xtitoris/hellen-efi/misc/Refs/case.jpg

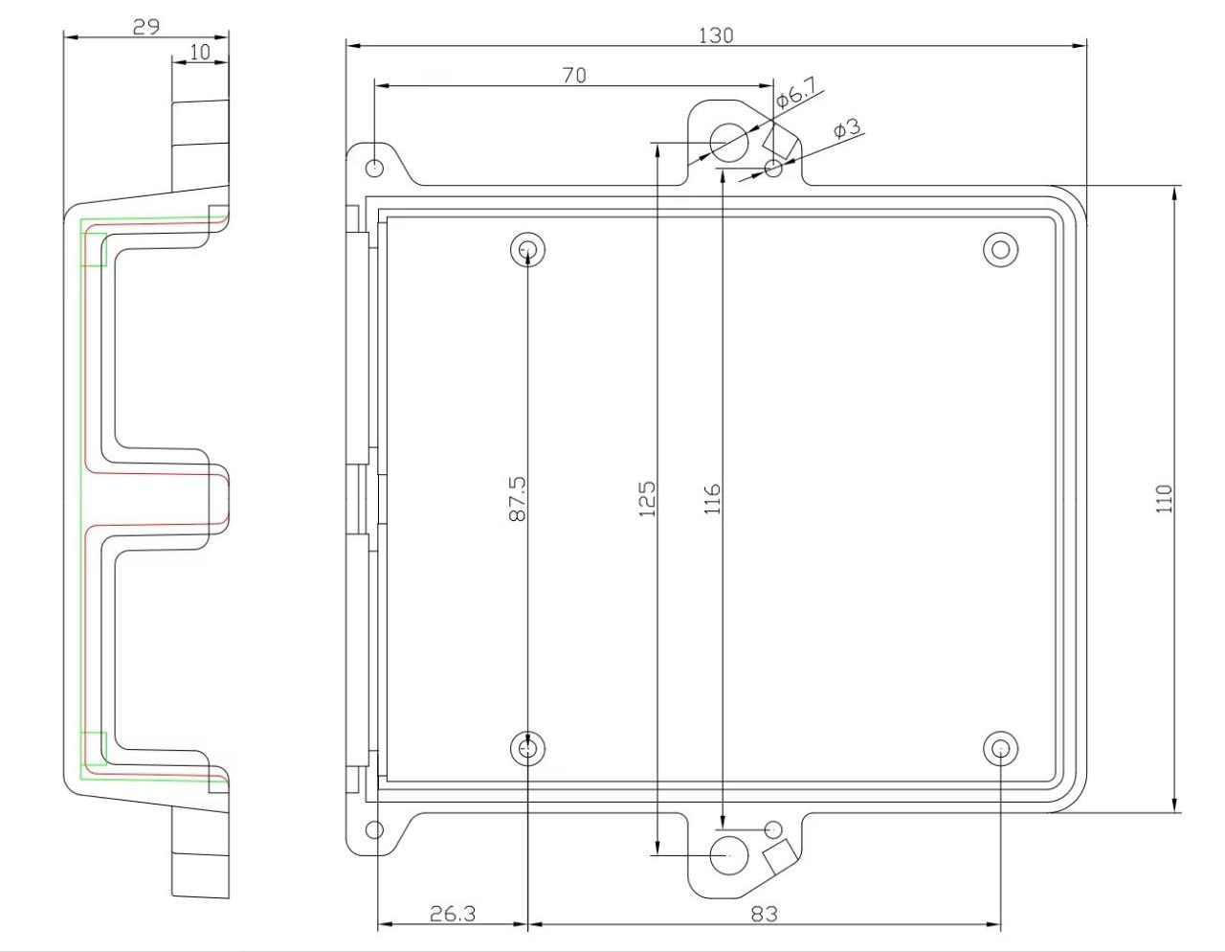
misc/Refs/case.jpg
