xtitoris/hellen-efi/misc/Refs/Conn.jpg

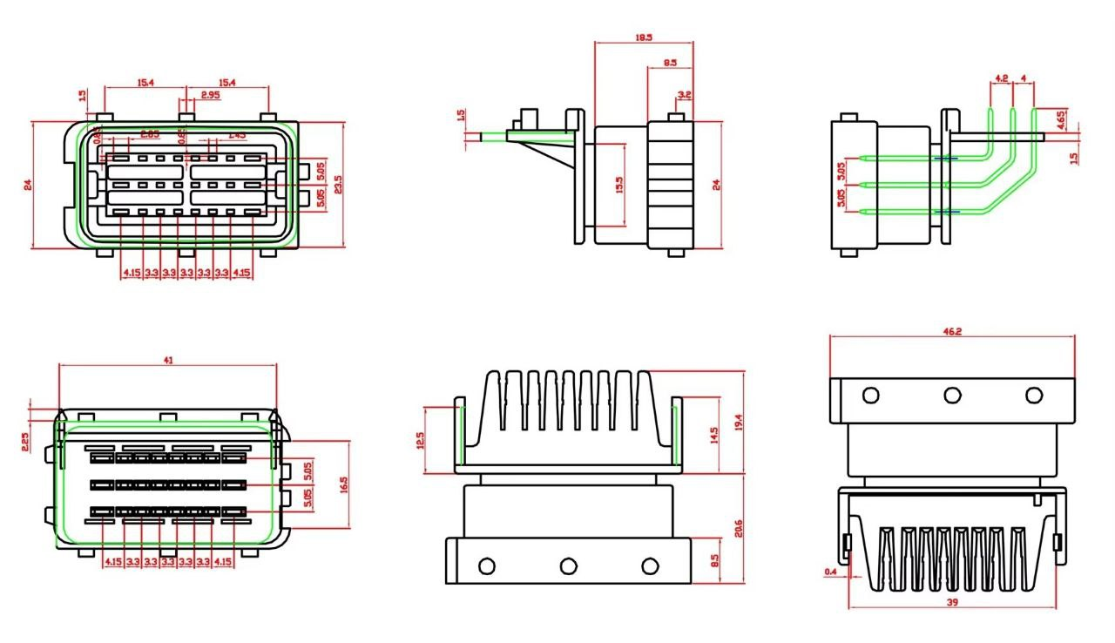
misc/Refs/Conn.jpg
