xtitoris/hellen-efi/misc/JDY-33.STEP

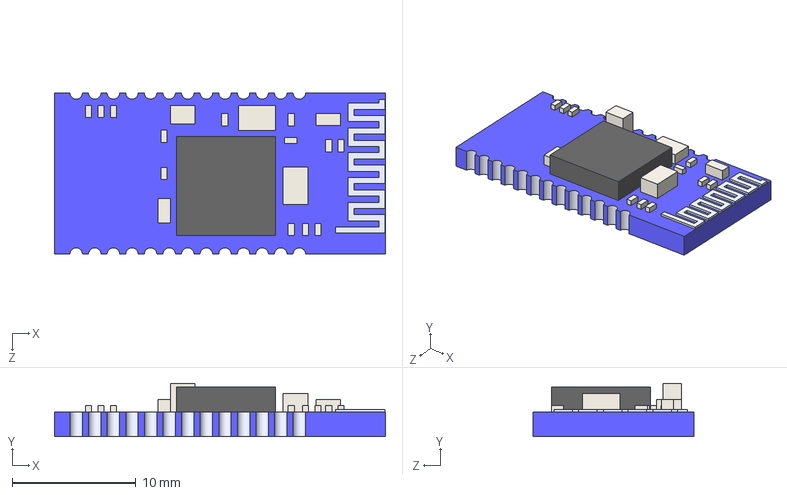
[picture p3: CAD file, 2026-09-19]
misc/JDY-33.STEP
26.7 x 4.30 x 13.0 mm
