xtitoris/hellen-efi/misc/Refs/outline.dxf

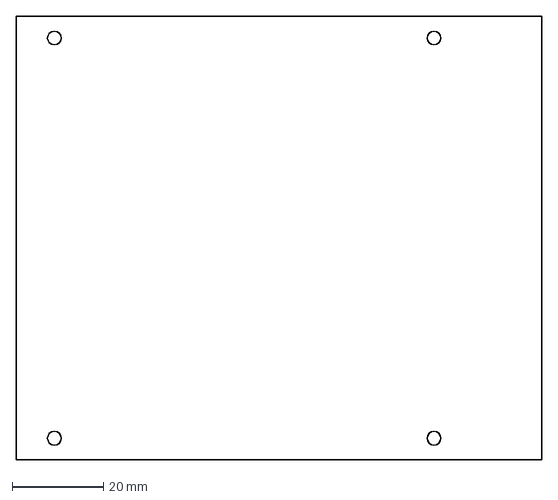
[picture p4: CAD file, 2025-12-07]
misc/Refs/outline.dxf
115.0 x 97.0 mm
