xtitoris/hellen-efi/misc/Refs/pcb.dxf

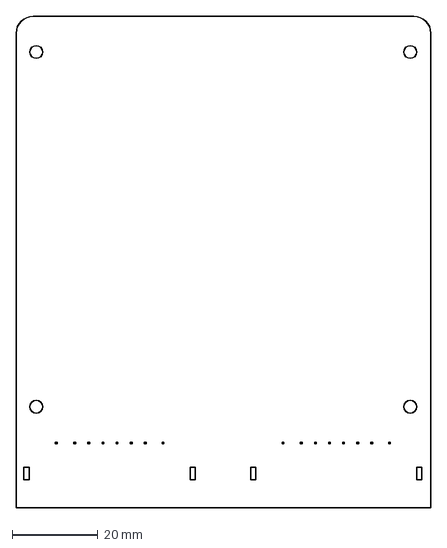
[picture p5: CAD file, 2025-12-07]
misc/Refs/pcb.dxf
97.0 x 115.0 mm
