xtitoris/hellen-efi/trove8.kicad_pcb

## KiCad design trove8.kicad_pcb (2026-09-19)

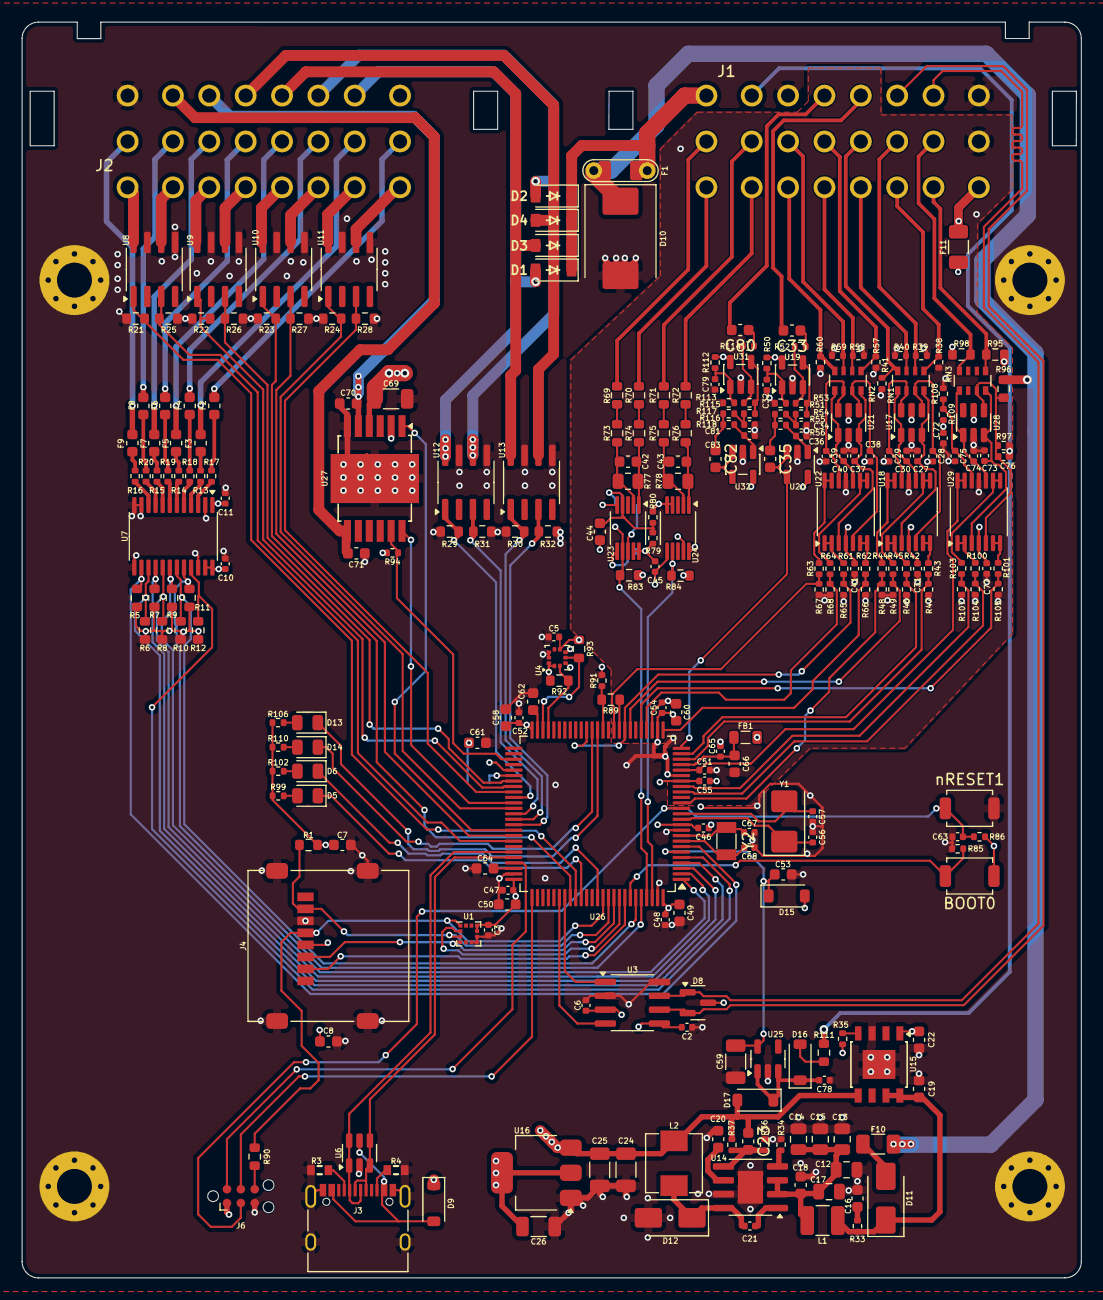
[picture p6: board trove8.kicad_pcb from above]

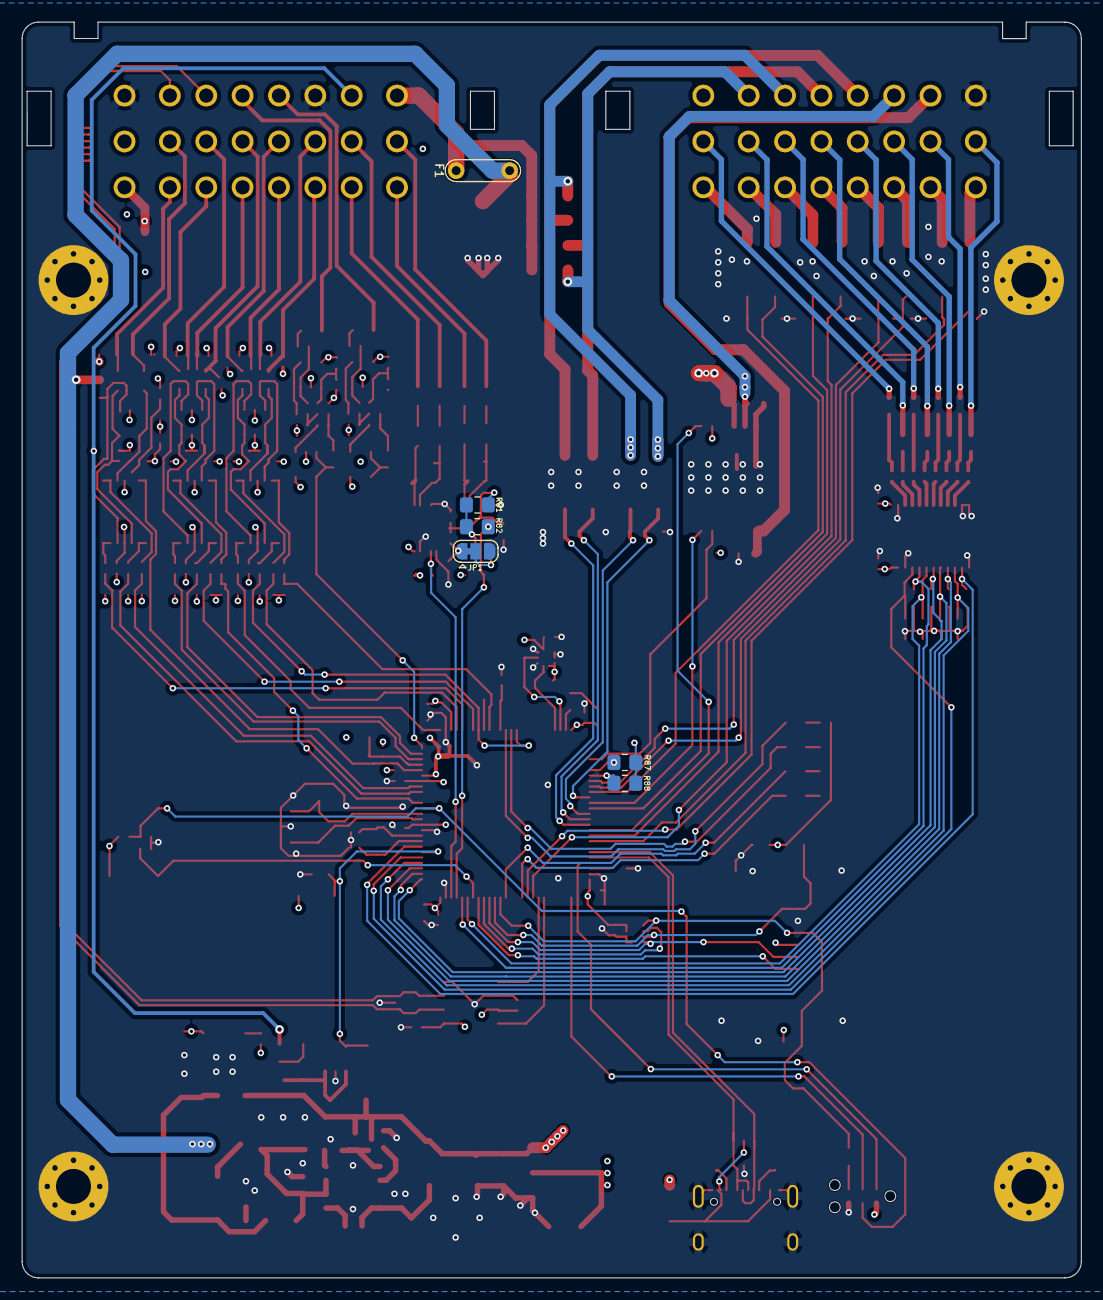
[picture p7: board trove8.kicad_pcb from below]

Board: 4 copper layers, 97.0 x 115.0 mm, 274 parts (5 on the bottom side), 204 nets.

Parts:
BOOT0: SW_Push; SW_SPST_TS-1088-xR020
C2, C3, C5, C6, C10, C11, C21, C27, C28, C29, C30, C31, C37, C38, C39, C40, C41, C45, C46, C47, C48, C51, C52, C54, C55, C63, C65, C72, C73, C74, C75, C77, C78: 100n; C_0402_1005Metric
C7, C8: 22u; C_0603_1608Metric
C12, C13, C14, C15, C17: 10u; C_0805_2012Metric
C16, C49, C50, C53, C58, C60, C66: 4.7u; C_0603_1608Metric
C18, C19, C22, C44, C61: 1u; C_0603_1608Metric
C20, C70, C71: 10n; C_0603_1608Metric
C23, C35, C82: 330p; C_0603_1608Metric
C24, C69: 10u; C_1206_3216Metric
C25, C26, C59: 47u; C_1206_3216Metric
C32, C79: 10n; C_0402_1005Metric
C33, C80: 3.3n; C_0603_1608Metric
C34, C81: 680p; C_0402_1005Metric
C36, C83: 47p; C_0402_1005Metric
C42, C43: 1n; C_0603_1608Metric
C56, C57: 18p; C_0402_1005Metric
C62, C64: 2.2u; C_0603_1608Metric
C67, C68: 15p; C_0402_1005Metric
C76: 1u; C_0402_1005Metric
D1, D2, D3, D4: B5819W; SOD-123
D5: RED; LED_0805_2012Metric
D6: GREEN; LED_0805_2012Metric
D8: PESD1CAN; SOT-23
D9, D15, D16, D17: 1N5819WS; D_SOD-123
D10: SM15T33CA; D_SMC
D11, D12: SS34; D_SMA
D13: BLUE; LED_0805_2012Metric
D14: YELLOW; LED_0805_2012Metric
F1: 12H1500D; PAD-1206-PAD
F2, F3, F4, F5, F6, F7, F8, F9: 50mA; Fuse_0603_1608Metric
F10: Polyfuse; Fuse_1206_3216Metric
F11: 120mA; Fuse_1206_3216Metric
FB1: Ferrite_Bead; L_0805_2012Metric
H1, H2, H3, H4: M3; MountingHole_3.2mm_M3_Pad_Via
J1: CONN_INPUTS; Delphi_Sicma_24_Black
J2: CONN_OUTPUTS; Delphi_Sicma_24_Grey
J3: USB_C
J4: Micro_SD_Card; microSD_HC_Molex_47219-2001
J6: Conn_01x06; Tag-Connect_TC2030-IDC-NL_2x03_P1.27mm_Vertical
JP1: Jumper_3_Bridged12; SolderJumper-3_P1.3mm_Bridged12_RoundedPad1.0x1.5mm
L1: 2.2u; L_1210_3225Metric
L2: 10u; MWSA0503
NT1: NetTie_2; NetTie-2_SMD_Pad0.5mm
R1: 33k; R_0603_1608Metric
R3, R4: 5.6k; R0603
R5, R6, R7, R8, R9, R10, R11, R12, R21, R22, R23, R24, R25, R26, R27, R28, R29, R30, R31, R32, R69, R70, R71, R72, R73, R74, R75, R76, R83, R84: 4.7k; R_0603_1608Metric
R13, R14, R15, R16, R17, R18, R19, R20: 10; R_0402_1005Metric
R33: 1; R_0402_1005Metric
R34, R35, R85, R86, R91, R94, R97: 10k; R_0402_1005Metric
R36, R54, R116: 12k; R_0402_1005Metric
R37: 68k; R_0402_1005Metric
R38, R39, R40, R41, R53, R57, R58, R59, R60, R115: 470k; R_0402_1005Metric
R42, R43, R44, R45, R46, R47, R48, R49, R61, R62, R63, R64, R65, R66, R67, R68, R100, R101, R103, R104, R105, R107, R108, R109: 4k7; R_0402_1005Metric
R50, R51, R56, R112, R113, R118: 33k; R_0402_1005Metric
R52, R55, R114, R117: 100k; R_0402_1005Metric
R77, R78: DNP; R_0805_2012Metric
R79, R80: 1k; R_0402_1005Metric
R81, R82, R87, R88: DNP; R_0805_2012Metric_Pad1.20x1.40mm_HandSolder
R89: 0; R_0603_1608Metric
R90: 100; R_0603_1608Metric
R92, R93: 2k2; R_0603_1608Metric
R95, R98: 2.7k; R_0603_1608Metric
R96: 48.7k; R_0603_1608Metric
R99, R102, R106, R110: 470; R_0402_1005Metric
R111: 6.8k; R_0603_1608Metric
RN1, RN2, RN3: 10k; R_Array_Convex_4x0603
U1: LIS2DW12TR; LGA-12_2x2mm_P0.5mm
U3: TJA1051T-3; SOIC-8_3.9x4.9mm_P1.27mm
U4: LPS22HB; ST_HLGA-10_2x2mm_P0.5mm_LayoutBorder3x2y
U6: USBLC6-2SC6; SOT-23-6
U7: SN74LVC4245APWR; TSSOP-24_4.4x7.8mm_P0.65mm
U8, U9, U10, U11, U12, U13: VNLD5160TR-E; SOIC-8_3.9x4.9mm_P1.27mm
U14: LMR14020; SOIC-8-1EP_3.9x4.9mm_P1.27mm_EP2.29x3mm
U15: TLS115; Infineon_PG-DSO-8-43
U16: AMS1117-3.3; SOT-223-3_TabPin2
U17, U21, U28: SRV05-4; SOT-23-6
U18, U22, U29: MCP6004; TSSOP-14_4.4x5mm_P0.65mm
U19, U20, U31, U32: LMV321; SOT-23-5
U23, U24: MAX9924; MSOP-10_3x3mm_P0.5mm
U25: MIC5205-3.3YM5; SOT-23-5
U26: STM32F427VGTx; LQFP-100_14x14mm_P0.5mm
U27: TLE9201SG; Infineon_PG-DSO-12-9
Y1: 20MHz; Crystal_SMD_5032-2Pin_5.0x3.2mm
Y2: 32.768 kHz; Crystal_SMD_3215-2Pin_3.2x1.5mm
nRESET1: SW_Push; SW_SPST_TS-1088-xR020

Connections:
+3.3V: BOOT0.2, C2.1, C3.1, C5.1, C7.1, C8.1, C10.1, C26.1, C46.2, C47.2, C48.2, C49.2, C50.2, C52.2, C54.2, C55.2, C58.2, C60.2, D15.2 (A), FB1.1, J4.4 (VDD), J6.1, R1.1, R35.2, R50.2, R83.1, R84.1, R86.2, R92.2, R93.2, R94.2, R99.1, R102.1, R106.1, R110.1, R112.2, U1.9 (Vdd), U1.10 (Vdd_IO), U3.5 (VIO), U4.1 (Vdd_IO), U4.6 (~CS), U4.10 (VDD), U7.23 (V_{CCB}), U7.24 (V_{CCB}), U16.2 (VO), U19.5 (V+), U20.5 (V+), U26.11 (VDD), U26.19 (VDD), U26.28 (VDD), U26.50 (VDD), U26.75 (VDD), U26.100 (VDD), U27.2 (VSO), U31.5 (V+), U32.5 (V+)
+5V: C6.1, C11.1, C23.1, C24.1, C25.1, C45.1, D9.1 (K), D17.2 (A), JP1.1 (A), L2.2, R37.2, R79.1, U3.3 (VCC), U7.1 (V_{CCA}), U15.5 (ADJ), U16.3 (VI), U23.9 (INT_THRS), U23.10 (VCC), U24.10 (VCC)
+5VA: C22.1, C31.1, C41.1, C72.2, C77.1, F11.1, R95.1, R98.1, R109.1, U15.1 (OUT), U17.5 (VP), U18.4 (V+), U21.5 (VP), U22.4 (V+), U28.5 (VP), U29.4 (V+)
+12V_IN: C69.2, D1.1 (K), D2.1 (K), D3.1 (K), D4.1 (K), F1.1, J1.C1, U27.4 (VS)
+12V_PERM: J1.C2, R111.1
+12V_PROT: C19.1, D11.1 (K), L1.1, R33.1, U15.7 (EN), U15.8 (IN)
+12V_RAW: D10.1 (A1), F1.2, F10.1, R96.1
/ACC_CS: U1.2 (~CS), U26.92 (PB6)
/Analog 3 Pullup/IN1_PRE: C73.1, RN3.8 (R1.2), U28.3 (IO2), U29.3 (+)
/Analog 3 Pullup/IN2_PRE: C74.1, RN3.5 (R4.2), U28.1 (IO1), U29.10 (+)
/Analog 3 Pullup/VIGN_PRE: C76.1, R96.2, R97.1, RN3.7 (R2.2), U28.4 (IO3), U29.5 (+)
/Analog 3 Pullup/VREF_PRE: C75.1, R108.1, R109.2, U29.12 (+)
/BARO_SCL: R92.1, U4.2 (SCL), U26.47 (PB10)
/BARO_SDA: R93.1, U4.4 (SDA), U26.48 (PB11)
/CAN1_RX: U3.4 (RXD), U26.81 (PD0)
/CAN1_TX: U3.1 (TXD), U26.82 (PD1)
/CAN_N: D8.2 (D), J1.C6, U3.6 (CANL)
/CAN_P: D8.1 (G), J1.C7, U3.7 (CANH)
/DC1_DIS: R94.1, U26.53 (PB14), U27.11 (DIS)
/IGN_1: F9.1, J2.B1
/IGN_2: F8.1, J2.B2
/IGN_3: F7.1, J2.B3
/IGN_4: F6.1, J2.B4
/IGN_5: F5.1, J2.B5
/IGN_6: F4.1, J2.B6
/IGN_7: F3.1, J2.B7
/IGN_8: F2.1, J2.B8
/INJ_1: J2.A1, U8.8 (D1)
/INJ_2: J2.A2, U8.6 (D2)
/INJ_3: J2.A3, U9.8 (D1)
/INJ_4: J2.A4, U9.6 (D2)
/INJ_5: J2.A5, U10.8 (D1)
/INJ_6: J2.A6, U10.6 (D2)
/INJ_7: J2.A7, U11.8 (D1)
/INJ_8: J2.A8, U11.6 (D2)
/IN_AC_CLUTCH: J1.B5, R41.1, RN1.4 (R4.1)
/IN_CAM_NEGATIVE: J1.A2, R72.2
/IN_CAM_PRIMARY: J1.B2, R71.2
/IN_CLT: J1.A7, R95.2, RN3.1 (R1.1)
/IN_CRANK_NEGATIVE: J1.A1, R70.2
/IN_CRANK_PRIMARY: J1.B1, R69.2
/IN_IAT: J1.B7, R98.2, RN3.4 (R4.1)
/IN_KNOCK: C33.2, J1.C5
/IN_KNOCK2: C80.2, J1.C4
/IN_MAP: J1.A5, R40.1, RN1.3 (R3.1)
/IN_O2S: J1.A6, R38.1, RN1.1 (R1.1)
/IN_O2S2: J1.B6, R39.1, RN1.2 (R2.1)
/IN_PPS1: J1.A4, R58.1, RN2.2 (R2.1)
/IN_PPS2: J1.B4, R57.1, RN2.1 (R1.1)
/IN_TPS_1: J1.A3, R60.1, RN2.4 (R4.1)
/IN_TPS_2: J1.B3, R59.1, RN2.3 (R3.1)
/Knock1/FILTERED_1: C82.2, U32.3 (-), U32.4
/Knock1/V_mid: C79.2, R112.1, R113.1, U31.1 (+)
/Knock/V_mid: C32.2, R50.1, R51.1, U19.1 (+)
/MCU/BOOT0: BOOT0.1, R85.1, U26.94 (BOOT0)
/MCU/BOOT1: R89.2, R91.1, U26.37 (PB2)
/MCU/LED1: D5.1 (K), U26.85 (PD4)
/MCU/LED2: D6.1 (K), U26.88 (PD7)
/MCU/LED3: D13.1 (K), U26.38 (PE7)
/MCU/LED4: D14.1 (K), U26.39 (PE8)
/MCU/SWCLK: J6.4, U26.76 (PA14)
/MCU/SWDIO: J6.2, U26.72 (PA13)
/MCU/SWO: J6.6, R90.2
/MCU/VDDA: C65.1, C66.1, FB1.2, U26.22 (VDDA)
/MCU/nRESET: C63.2, J6.3, R86.1, U26.14 (NRST), nRESET1.1
/MCU_IGN1: R5.2, U7.14 (B8), U26.7 (PC13)
/MCU_IGN2: R6.2, U7.15 (B7), U26.4 (PE5)
/MCU_IGN3: R7.2, U7.16 (B6), U26.3 (PE4)
/MCU_IGN4: R8.2, U7.17 (B5), U26.2 (PE3)
/MCU_IGN5: R9.2, U7.18 (B4), U26.1 (PE2)
/MCU_IGN6: R10.2, U7.19 (B3), U26.95 (PB8)
/MCU_IGN7: R11.2, U7.20 (B2), U26.96 (PB9)
/MCU_IGN8: R12.2, U7.21 (B1), U26.5 (PE6)
/MCU_INJ1: R21.2, U8.1 (IN1), U26.84 (PD3)
/MCU_INJ2: R25.2, U8.3 (IN2), U26.68 (PA9)
/MCU_INJ3: R22.2, U9.1 (IN1), U26.58 (PD11)
/MCU_INJ4: R26.2, U9.3 (IN2), U26.57 (PD10)
/MCU_INJ5: R23.2, U10.1 (IN1), U26.83 (PD2)
/MCU_INJ6: R27.2, U10.3 (IN2), U26.67 (PA8)
/MCU_INJ7: R24.2, U11.1 (IN1), U26.62 (PD15)
/MCU_INJ8: R28.2, U11.3 (IN2), U26.59 (PD12)
/MCU_IN_AC_CLUTCH: R45.1, R49.2, U26.32 (PA7)
/MCU_IN_AUX_PU1: R89.1, U26.34 (PC5)
/MCU_IN_CAM: R84.2, U24.7 (COUT), U26.98 (PE1)
/MCU_IN_CLT: R100.1, R104.2, U26.17 (PC2)
/MCU_IN_CRANK: R82.1, R83.2, U23.7 (COUT), U26.97 (PE0)
/MCU_IN_IAT: R103.1, R107.2, U26.18 (PC3)
/MCU_IN_KNOCK: C35.2, U20.3 (-), U20.4, U26.25 (PA2)
/MCU_IN_MAP: R44.1, R48.2, U26.15 (PC0)
/MCU_IN_O2S: R42.1, R46.2, U26.24 (PA1)
/MCU_IN_O2S2: R43.1, R47.2, U26.23 (PA0)
/MCU_IN_PPS1: R62.1, R66.2, U26.26 (PA3)
/MCU_IN_PPS2: R61.1, R65.2, U26.33 (PC4), U26.40 (PE9)
/MCU_IN_TPS_1: R64.1, R68.2, U26.29 (PA4)
/MCU_IN_TPS_2: R63.1, R67.2, U26.35 (PB0)
/MCU_IN_VIGN: R101.1, R105.2, U26.30 (PA5)
/MCU_PWM1: R29.2, U12.1 (IN1), U26.60 (PD13)
/MCU_PWM2: R31.2, U12.3 (IN2), U26.63 (PC6)
/MCU_PWM3: R30.2, U13.1 (IN1), U26.64 (PC7)
/MCU_PWM4: R32.2, U13.3 (IN2), U26.65 (PC8)
/MCU_PWM5: U26.66 (PC9), U27.1 (DIR)
/MCU_PWM6: U26.61 (PD14), U27.12 (PWM)
/MCU_VREF: C51.1, U26.21 (VREF+), U29.13 (-), U29.14
/OUT_DH: C70.2, J2.C3, U27.5 (OUT1)
/OUT_DL: C71.1, J2.C2, U27.7 (OUT2)
/OUT_LS1: D1.2 (A), J2.C7, U12.8 (D1)
/OUT_LS2: D2.2 (A), J2.C6, U12.6 (D2)
/OUT_LS3: D3.2 (A), J2.C5, U13.8 (D1)
/OUT_LS4: D4.2 (A), J2.C4, U13.6 (D2)
/SD_CS: J4.2 (DAT3/CD), U26.93 (PB7)
/SPI1_MISO: J4.7 (DAT0), R1.2, U1.3 (SA0/SDO), U26.90 (PB4)
/SPI1_MOSI: J4.3 (CMD), U1.4 (SDA/SDI), U26.91 (PB5)
/SPI1_SCK: J4.5 (CLK), R90.1, U1.1 (SCL/SPC), U26.89 (PB3)
/USB_D+: J3.A6 (D+), J3.B6 (D+), U6.3 (I/O2), U6.4 (I/O2), U26.71 (PA12)
/USB_D-: J3.A7 (D-), J3.B7 (D-), U6.1 (I/O1), U6.6 (I/O1), U26.70 (PA11)
/USB_VBUS: D9.2 (A), J3.A4 (VBUS), J3.A9 (VBUS), J3.B4 (VBUS), J3.B9 (VBUS), U6.5 (VBUS)
/VBAT: C53.1, C59.1, D15.1 (K), U25.5 (OUT), U26.6 (VBAT)
/VReg/5V_SENSOR_1_PG: R35.1, U15.4 (PG)
/VReg/12V_PRE: C12.1, C13.1, C14.1, C15.1, C17.1, C18.1, L1.2, U14.2 (VIN), U14.3 (EN)
GND: C2.2, C3.2, C5.2, C6.2, C7.2, C8.2, C10.2, C11.2, C12.2, C13.2, C14.2, C15.2, C16.2, C17.2, C18.2, C19.2, C20.2, C22.2, C24.2, C25.2, C26.2, C44.2, C45.2, C46.1, C47.1, C48.1, C49.1, C50.1, C52.1, C53.2, C54.1, C55.1, C56.2, C57.2, C58.1, C59.2, C60.1, C61.2, C62.2, C63.1, C64.2, C67.2, C68.2, C69.1, C70.1, C71.2, C78.2, D8.3 (S), D10.2 (A2), D12.2 (A), H1.1 (1_1), H2.1 (1_1), H3.1 (1_1), H4.1 (1_1), J1.C3, J1.C8, J2.C1, J2.C8, J3.A1 (GND), J3.A12 (GND), J3.B1 (GND), J3.B12 (GND), J3.S1 (SHIELD), J4.6 (VSS), J4.9 (SHIELD), J6.5, JP1.3 (B), NT1.1, R3.1, R4.1, R5.1, R6.1, R7.1, R8.1, R9.1, R10.1, R11.1, R12.1, R21.1, R22.1, R23.1, R24.1, R25.1, R26.1, R27.1, R28.1, R29.1, R30.1, R31.1, R32.1, R34.2, R36.2, R80.1, R85.2, R91.2, U1.6 (GND), U1.7 (RES), U1.8 (GND), U3.2 (GND), U3.8 (S), U4.3 (GND), U4.5 (SA0), U4.8 (GND), U4.9 (GND), U6.2 (GND), U7.2 (DIR), U7.11 (GND), U7.12 (GND), U7.13 (GND), U7.22 (~OE), U8.5 (S2), U8.7 (S1), U9.5 (S2), U9.7 (S1), U10.5 (S2), U10.7 (S1), U11.5 (S2), U11.7 (S1), U12.5 (S2), U12.7 (S1), U13.5 (S2), U13.7 (S1), U14.7 (GND), U14.9 (GND), U15.3 (GND), U15.9 (GND), U16.1 (GND), U23.5 (GND), U24.4 (BIAS), U24.5 (GND), U24.6 (ZERO_EN), U24.9 (INT_THRS), U25.2 (GND), U26.10 (VSS), U26.27 (VSS), U26.74 (VSS), U26.99 (VSS), U27.6 (GND), U27.13 (GND), nRESET1.2
GNDA: C27.2, C28.2, C29.2, C30.2, C31.2, C32.1, C34.1, C36.1, C37.2, C38.2, C39.2, C40.2, C41.2, C51.2, C65.2, C66.2, C72.1, C73.2, C74.2, C75.2, C76.2, C77.2, C79.1, C81.1, C83.1, J1.B8, NT1.2, R38.2, R39.2, R40.2, R41.2, R46.1, R47.1, R48.1, R49.1, R51.2, R57.2, R58.2, R59.2, R60.2, R65.1, R66.1, R67.1, R68.1, R97.2, R104.1, R105.1, R107.1, R108.2, R113.2, U17.2 (VN), U18.11 (V-), U19.2 (V-), U20.2 (V-), U21.2 (VN), U22.11 (V-), U26.20 (VSSA), U28.2 (VN), U29.11 (V-), U31.2 (V-), U32.2 (V-)
unnamed: C16.1, R33.2
unnamed: C33.1, R52.2
unnamed: C34.2, R54.1, R55.2
unnamed: C35.1, R55.1, R56.2
unnamed: C61.1, R87.1, R88.1
unnamed: C80.1, R114.2
unnamed: C81.2, R116.1, R117.2
unnamed: C82.1, R117.1, R118.2
unnamed: D5.2 (A), R99.2
unnamed: D6.2 (A), R102.2
unnamed: D11.2 (A), F10.2
unnamed: C21.2, D12.1 (K), L2.1, U14.8 (SW)
unnamed: D13.2 (A), R106.2
unnamed: D14.2 (A), R110.2
unnamed: D16.2 (A), R111.2
unnamed: C78.1, D16.1 (K), D17.1 (K), U25.1 (IN), U25.3 (EN)
unnamed: F2.2, R17.2
unnamed: F3.2, R13.2
unnamed: F4.2, R18.2
unnamed: F5.2, R14.2
unnamed: F6.2, R19.2
unnamed: F7.2, R15.2
unnamed: F8.2, R20.2
unnamed: F9.2, R16.2
unnamed: F11.2, J1.A8
unnamed: J3.A5 (CC1), R3.2
unnamed: J3.B5 (CC2), R4.2
unnamed: JP1.2 (C), U23.6 (ZERO_EN)
unnamed: R53.1, R54.2, U19.4
unnamed: R69.1, R73.2
unnamed: R70.1, R74.2
unnamed: R71.1, R75.2
unnamed: R72.1, R76.2
unnamed: R115.1, R116.2, U31.4
unnamed: C27.1, RN1.8 (R1.2), U17.3 (IO2), U18.3 (+)
unnamed: C28.1, RN1.7 (R2.2), U17.4 (IO3), U18.5 (+)
unnamed: C29.1, RN1.6 (R3.2), U17.6 (IO4), U18.12 (+)
unnamed: C30.1, RN1.5 (R4.2), U17.1 (IO1), U18.10 (+)
unnamed: C37.1, RN2.8 (R1.2), U21.3 (IO2), U22.3 (+)
unnamed: C38.1, RN2.7 (R2.2), U21.4 (IO3), U22.5 (+)
unnamed: C39.1, RN2.6 (R3.2), U21.6 (IO4), U22.12 (+)
unnamed: C40.1, RN2.5 (R4.2), U21.1 (IO1), U22.10 (+)
unnamed: R17.1, U7.3 (A1)
unnamed: R13.1, U7.4 (A2)
unnamed: R18.1, U7.5 (A3)
unnamed: R14.1, U7.6 (A4)
unnamed: R19.1, U7.7 (A5)
unnamed: R15.1, U7.8 (A6)
unnamed: R20.1, U7.9 (A7)
unnamed: R16.1, U7.10 (A8)
unnamed: C21.1, U14.1 (BOOT)
unnamed: C23.2, R36.1, R37.1, U14.5 (FB)
unnamed: R34.1, U14.4 (RT)
unnamed: C20.1, U14.6 (SS)
unnamed: R42.2, U18.1, U18.2 (-)
unnamed: R43.2, U18.6 (-), U18.7
unnamed: R45.2, U18.8, U18.9 (-)
unnamed: R44.2, U18.13 (-), U18.14
unnamed: R52.1, R53.2, U19.3 (-)
unnamed: C36.2, R56.1, U20.1 (+)
unnamed: R61.2, U22.1, U22.2 (-)
unnamed: R62.2, U22.6 (-), U22.7
unnamed: R64.2, U22.8, U22.9 (-)
unnamed: R63.2, U22.13 (-), U22.14
unnamed: C44.1, R79.2, R80.2, R81.2, U23.4 (BIAS)
unnamed: R81.1, R82.2, U23.8 (EXT)
unnamed: C42.2, R74.1, R77.1, U23.1 (IN+)
unnamed: C42.1, R73.1, R77.2, U23.2 (IN-)
unnamed: C43.2, R76.1, R78.1, U24.1 (IN+)
unnamed: C43.1, R75.1, R78.2, U24.2 (IN-)
unnamed: C68.1, U26.8 (PC14), Y2.1
unnamed: C67.1, U26.9 (PC15), Y2.2
unnamed: R87.2, U26.55 (PD8)
unnamed: R88.2, U26.56 (PD9)
unnamed: C56.1, U26.12 (PH0), Y1.1
unnamed: C57.1, U26.13 (PH1), Y1.2
unnamed: C62.1, U26.49 (VCAP_1)
unnamed: C64.1, U26.73 (VCAP_2)
unnamed: R100.2, U29.1, U29.2 (-)
unnamed: R101.2, U29.6 (-), U29.7
unnamed: R103.2, U29.8, U29.9 (-)
unnamed: R114.1, R115.2, U31.3 (-)
unnamed: C83.2, R118.1, U32.1 (+)
