xtitoris/hellen-efi/(commit log)

2025-12-07 Rev 0
    [DC_MOTOR_0.1.kicad_sch, IGN8.kicad_sch, INJ8.kicad_sch, LS4.kicad_sch, LS6.kicad_sch, LS_HOT.kicad_sch, MAP.kicad_sch, VReg.kicad_sch]
2025-12-12 Standalone version without hellen-one
    [DC_MOTOR_0.1.kicad_sch, IGN8.kicad_sch, INJ8.kicad_sch, LS4.kicad_sch, LS6.kicad_sch, LS_HOT.kicad_sch, MAP.kicad_sch, VReg.kicad_sch]
